LesniakM/sbr/hardware/sbr-pcb/pinout.png

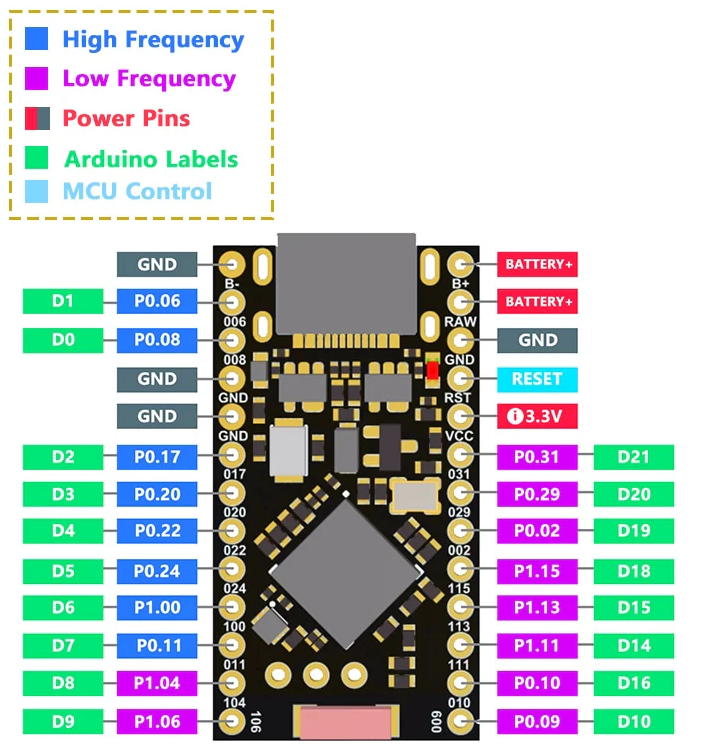
hardware/sbr-pcb/pinout.png
