LesniakM/sbr/hardware/sbr-pcb/sbr-pcb.kicad_pcb

## KiCad design hardware/sbr-pcb/sbr-pcb.kicad_pcb (2025-09-09)

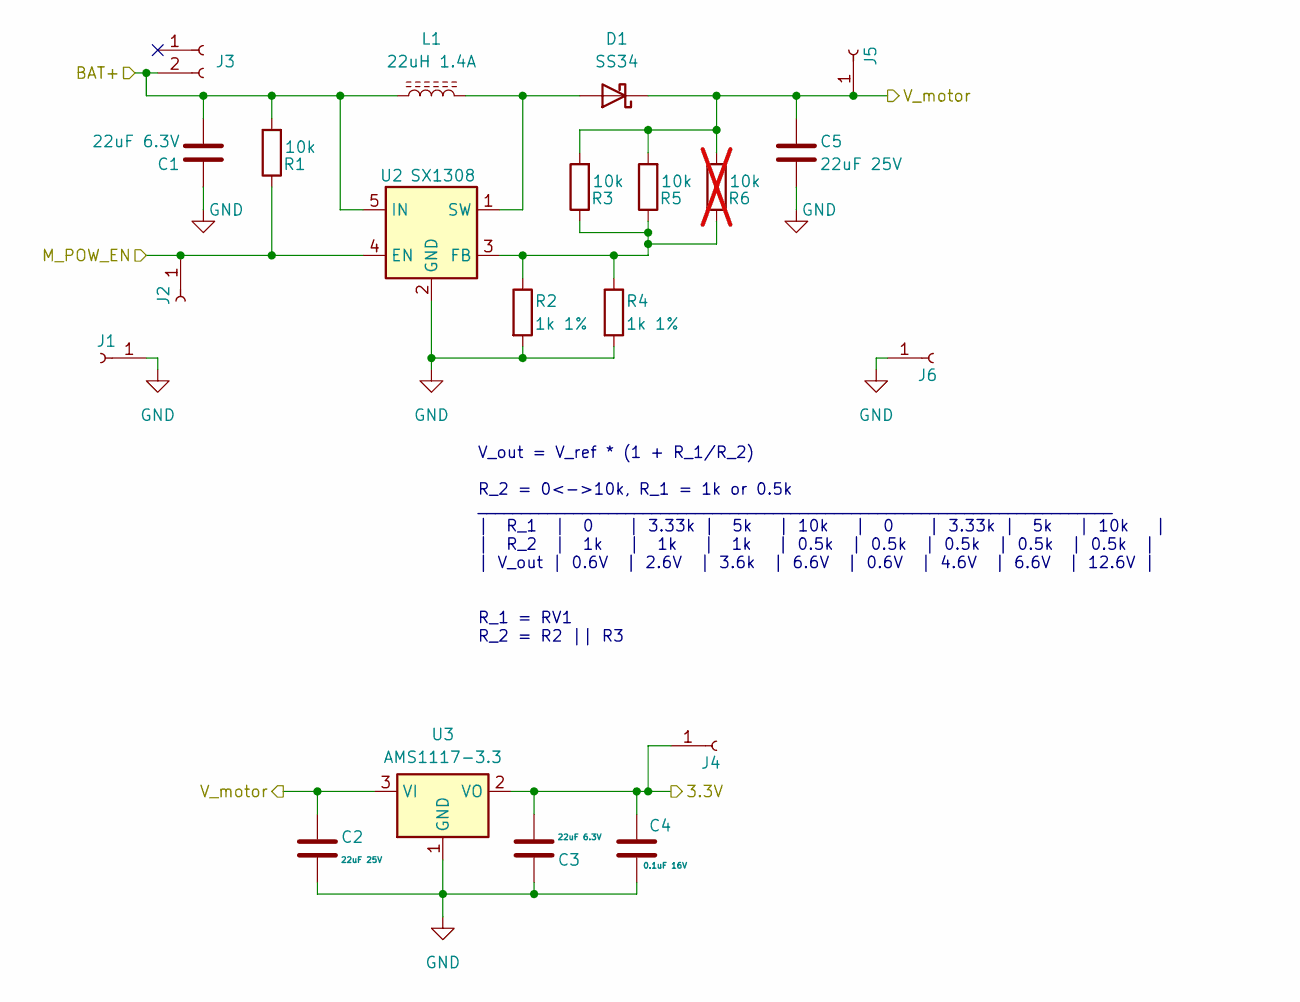
[picture p2: schematic power_managment.kicad_sch]

Parts:
C1, C3: 22uF 6.3V; C_0603_1608Metric; JLCPCB# C59461
C2, C5: 22uF 25V; C_0805_2012Metric; JLCPCB# C45783
C4: 0.1uF 16V; C_0402_1005Metric; JLCPCB# C1525
D1: SS34; D_SMA; JLCPCB# C8678
J1, J2, J4, J5, J6: Conn_hole; PinHeader_1x01_P2.54mm_Vertical
J3: Conn_01x02_Socket; PinHeader_1x02_P2.54mm_Vertical
L1: 22uH 1.4A; L_TDK_VLS6045EX_VLS6045AF; JLCPCB# C241601
R1, R3, R5: 10k; R_0603_1608Metric; JLCPCB# C25804
R2, R4: 1k 1%; R_0603_1608Metric; JLCPCB# C21190
R6: 10k; R_0603_1608Metric; JLCPCB# C25804; not fitted
U2: SX1308; SOT-23-6; LCSC Part # C78162
U3: AMS1117-3.3; SOT-223-3_TabPin2; JLCPCB# C6186

Connections:
/IMU/3.3V: C3.2, C4.1, J4.1, U3.2 (VO); also elsewhere on the board
/MCU/BAT+: C1.2, J3.2, L1.1, R1.2, U2.5 (IN); also elsewhere on the board
/MCU/M_POW_EN: J2.1, R1.1, U2.4 (EN); also elsewhere on the board
/motor_control/V_motor: C2.1, C5.1, D1.1 (K), J5.1, R3.2, R5.2, R6.2, U3.3 (VI); also elsewhere on the board
GND: C1.1, C2.2, C3.1, C4.2, C5.2, J1.1, J6.1, R2.2, R4.2, U2.2 (GND), U3.1 (GND); also elsewhere on the board
unnamed: D1.2 (A), L1.2, U2.1 (SW)
unnamed: R2.1, R3.1, R4.1, R5.1, R6.1, U2.3 (FB)

Notes on the sheet:
V_out = V_ref * (1 + R_1/R_2) R_2 = 0<->10k, R_1 = 1k or 0.5k _________________________________________________________________________ | R_1 | 0 | 3.33k | 5k | 10k | 0 | 3.33k | 5k | 10k | | R_2 | 1k | 1k | 1k | 0.5k | 0.5k | 0.5k | 0.5k | 0.5k | | V_out | 0.6V | 2.6V | 3.6k | 6.6V | 0.6V | 4.6V |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

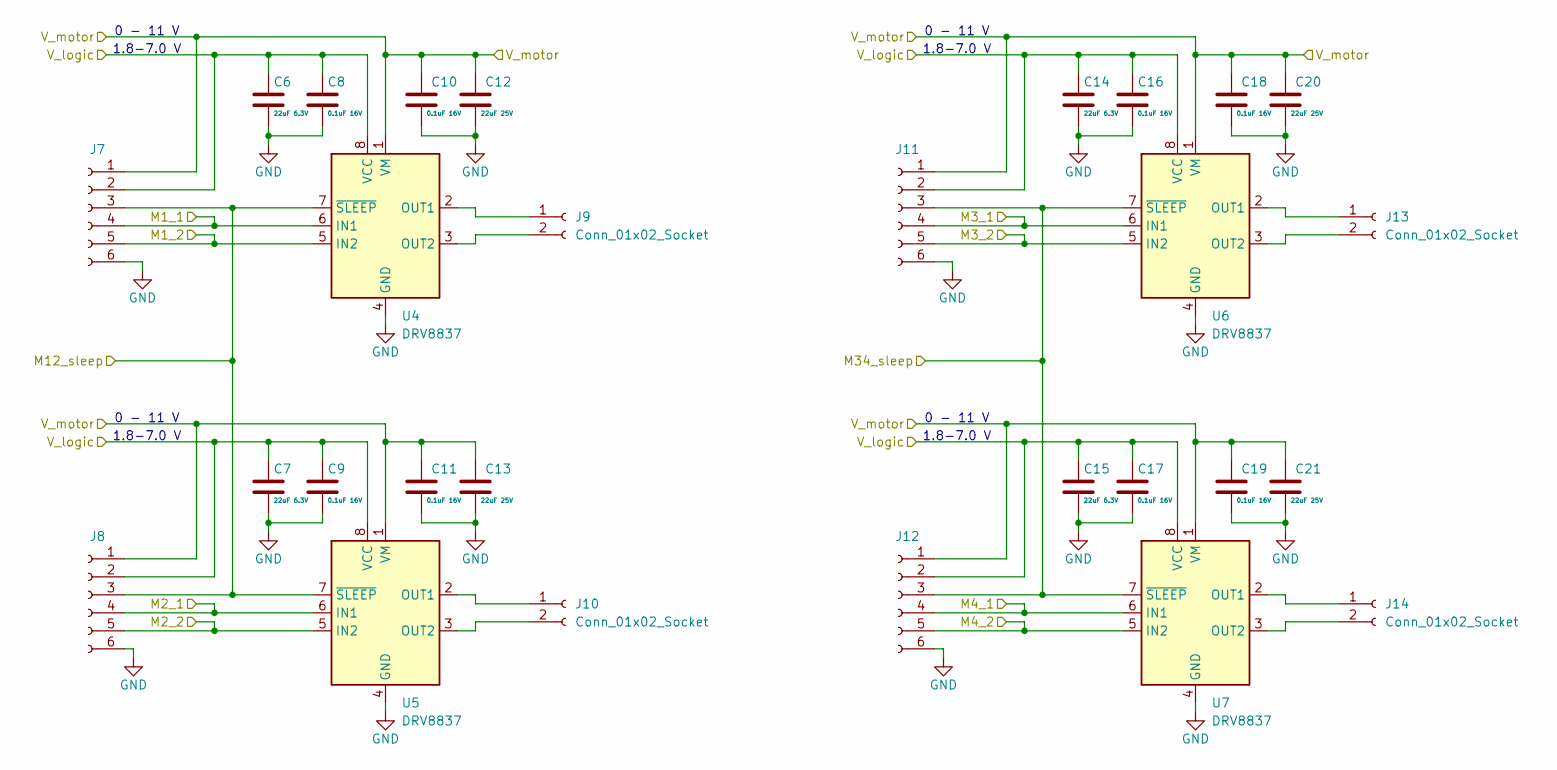
[picture p3: schematic motor_control.kicad_sch]

Parts:
C6, C7, C14, C15: 22uF 6.3V; C_0603_1608Metric; JLCPCB# C59461
C8, C9, C10, C11, C16, C17, C18, C19: 0.1uF 16V; C_0402_1005Metric; JLCPCB# C1525
C12, C13, C20, C21: 22uF 25V; C_0805_2012Metric; JLCPCB# C45783
J7, J8, J11, J12: Conn_01x06_Socket; PinHeader_1x06_P1.27mm_Vertical
J9, J10, J13, J14: Conn_01x02_Socket; PinSocket_1x02_P2.54mm_Vertical
U4, U5, U6, U7: DRV8837; WSON-8-1EP_2x2mm_P0.5mm_EP0.9x1.6mm; JLCPCB# C39159

Connections:
/IMU/3.3V: C6.1, C7.1, C8.1, C9.1, C14.1, C15.1, C16.1, C17.1, J7.2, J8.2, J11.2, J12.2, U4.8 (VCC), U5.8 (VCC), U6.8 (VCC), U7.8 (VCC); also elsewhere on the board
/MCU/M1_1: J7.4, U4.6 (IN1); also elsewhere on the board
/MCU/M1_2: J7.5, U4.5 (IN2); also elsewhere on the board
/MCU/M2_1: J8.4, U5.6 (IN1); also elsewhere on the board
/MCU/M2_2: J8.5, U5.5 (IN2); also elsewhere on the board
/MCU/M3_1: J11.4, U6.6 (IN1); also elsewhere on the board
/MCU/M3_2: J11.5, U6.5 (IN2); also elsewhere on the board
/MCU/M4_1: J12.4, U7.6 (IN1); also elsewhere on the board
/MCU/M4_2: J12.5, U7.5 (IN2); also elsewhere on the board
/MCU/M12_sleep: J7.3, J8.3, U4.7 (~SLEEP), U5.7 (~SLEEP); also elsewhere on the board
/MCU/M34_sleep: J11.3, J12.3, U6.7 (~SLEEP), U7.7 (~SLEEP); also elsewhere on the board
/motor_control/V_motor: C10.1, C11.1, C12.1, C13.1, C18.1, C19.1, C20.1, C21.1, J7.1, J8.1, J11.1, J12.1, U4.1 (VM), U5.1 (VM), U6.1 (VM), U7.1 (VM); also elsewhere on the board
GND: C6.2, C7.2, C8.2, C9.2, C10.2, C11.2, C12.2, C13.2, C14.2, C15.2, C16.2, C17.2, C18.2, C19.2, C20.2, C21.2, J7.6, J8.6, J11.6, J12.6, U4.4 (GND), U4.9 (GND), U5.4 (GND), U5.9 (GND), U6.4 (GND), U6.9 (GND), U7.4 (GND), U7.9 (GND); also elsewhere on the board
unnamed: J9.1, U4.2 (OUT1)
unnamed: J9.2, U4.3 (OUT2)
unnamed: J10.1, U5.2 (OUT1)
unnamed: J10.2, U5.3 (OUT2)
unnamed: J13.1, U6.2 (OUT1)
unnamed: J13.2, U6.3 (OUT2)
unnamed: J14.1, U7.2 (OUT1)
unnamed: J14.2, U7.3 (OUT2)

Notes on the sheet:
1.8-7.0 V
0 - 11 V

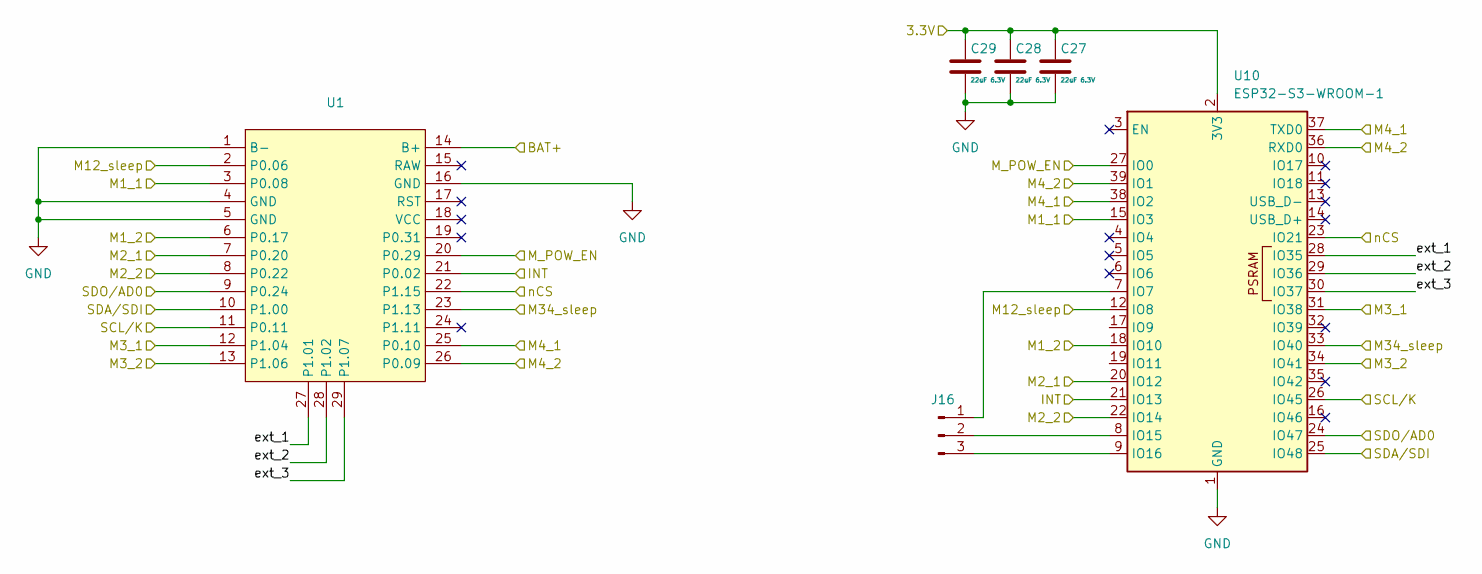
[picture p4: schematic mcu.kicad_sch]

Parts:
C27, C28, C29: 22uF 6.3V; C_0603_1608Metric; JLCPCB# C59461
J16: Conn_01x03_Pin; PinHeader_1x03_P2.54mm_Vertical
U1: ProMicro_nRF52840
U10: ESP32-S3-WROOM-1

Connections:
/IMU/3.3V: C27.1, C28.1, C29.1, U10.2 (3V3); also elsewhere on the board
/IMU/INT: U1.21 (P0.02), U10.21 (IO13); also elsewhere on the board
/IMU/SCL/K: U1.11 (P0.11), U10.26 (IO45); also elsewhere on the board
/IMU/SDA/SDI: U1.10 (P1.00), U10.25 (IO48); also elsewhere on the board
/IMU/SDO/AD0: U1.9 (P0.24), U10.24 (IO47); also elsewhere on the board
/IMU/nCS: U1.22 (P1.15), U10.23 (IO21); also elsewhere on the board
/MCU/BAT+: U1.14 (B+); also elsewhere on the board
/MCU/M1_1: U1.3 (P0.08), U10.15 (IO3); also elsewhere on the board
/MCU/M1_2: U1.6 (P0.17), U10.18 (IO10); also elsewhere on the board
/MCU/M2_1: U1.7 (P0.20), U10.20 (IO12); also elsewhere on the board
/MCU/M2_2: U1.8 (P0.22), U10.22 (IO14); also elsewhere on the board
/MCU/M3_1: U1.12 (P1.04), U10.31 (IO38); also elsewhere on the board
/MCU/M3_2: U1.13 (P1.06), U10.34 (IO41); also elsewhere on the board
/MCU/M4_1: U1.25 (P0.10), U10.37 (TXD0), U10.38 (IO2); also elsewhere on the board
/MCU/M4_2: U1.26 (P0.09), U10.36 (RXD0), U10.39 (IO1); also elsewhere on the board
/MCU/M12_sleep: U1.2 (P0.06), U10.12 (IO8); also elsewhere on the board
/MCU/M34_sleep: U1.23 (P1.13), U10.33 (IO40); also elsewhere on the board
/MCU/M_POW_EN: U1.20 (P0.29), U10.27 (IO0); also elsewhere on the board
/MCU/ext_1: U1.27 (P1.01), U10.28 (IO35)
/MCU/ext_2: U1.28 (P1.02), U10.29 (IO36)
/MCU/ext_3: U1.29 (P1.07), U10.30 (IO37)
GND: C27.2, C28.2, C29.2, U1.1 (B-), U1.4 (GND), U1.5 (GND), U1.16 (GND), U10.1 (GND), U10.40 (GND), U10.41 (GND); also elsewhere on the board
unnamed: J16.1, U10.7 (IO7)
unnamed: J16.2, U10.8 (IO15)
unnamed: J16.3, U10.9 (IO16)

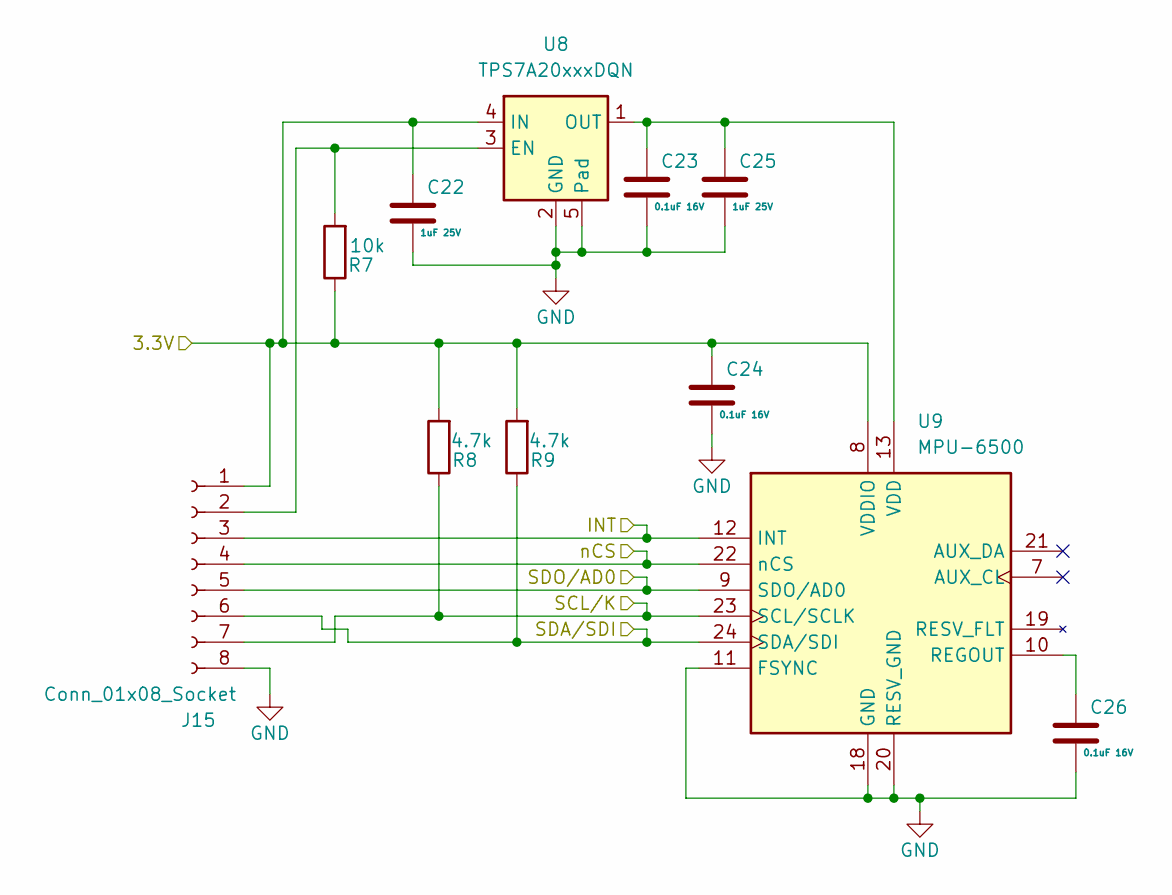
[picture p5: schematic imu.kicad_sch]

Parts:
C22, C25: 1uF 25V; C_0402_1005Metric; JLCPCB# C52923
C23, C24, C26: 0.1uF 16V; C_0402_1005Metric; JLCPCB# C1525
J15: Conn_01x08_Socket; PinSocket_1x08_P2.54mm_Vertical
R7: 10k; R_0603_1608Metric; JLCPCB# C25804
R8, R9: 4.7k; R_0603_1608Metric; JLCPCB# C23162
U8: TPS7A20xxxDQN; Texas_X2SON-4_1x1mm_P0.65mm; JLCPCB# C2878130
U9: MPU-6500; InvenSense_QFN-24_3x3mm_P0.4mm; JLCPCB# C50278

Connections:
/IMU/3.3V: C22.1, C24.1, J15.1, R7.1, R8.2, R9.2, U8.4 (IN), U9.8 (VDDIO); also elsewhere on the board
/IMU/INT: J15.3, U9.12 (INT); also elsewhere on the board
/IMU/SCL/K: J15.7, R8.1, U9.23 (SCL/SCLK); also elsewhere on the board
/IMU/SDA/SDI: J15.6, R9.1, U9.24 (SDA/SDI); also elsewhere on the board
/IMU/SDO/AD0: J15.5, U9.9 (SDO/AD0); also elsewhere on the board
/IMU/nCS: J15.4, U9.22 (nCS); also elsewhere on the board
GND: C22.2, C23.2, C24.2, C25.2, C26.2, J15.8, U8.2 (GND), U8.5 (Pad), U9.11 (FSYNC), U9.18 (GND), U9.20 (RESV_GND); also elsewhere on the board
unnamed: J15.2, R7.2, U8.3 (EN)
unnamed: C26.1, U9.10 (REGOUT)

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
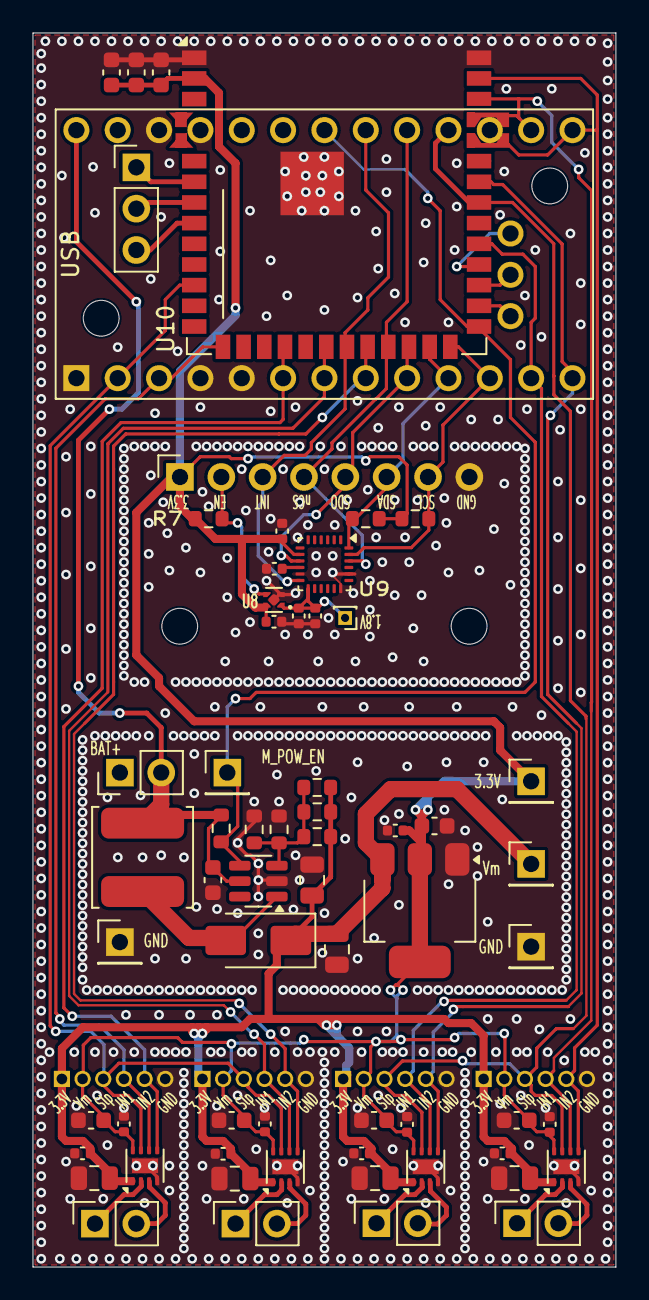
[picture p6: board sbr-pcb.kicad_pcb from above]

Board: 2 copper layers, 35.8 x 75.8 mm, 66 parts (0 on the bottom side), 39 nets.
