LesniakM/sbr/firmware/src/ble_comm.c

#include "ble_comm.h"

LOG_MODULE_REGISTER(SBR_BLE, LOG_LEVEL_DBG);

static struct sbr_callback sbr_cb;

static bool button_state;

BT_GATT_SERVICE_DEFINE(
    sbr_service, BT_GATT_PRIMARY_SERVICE(BT_UUID_SBR_SERVICE),

    BT_GATT_CHARACTERISTIC(BT_UUID_SBR_ACCEL, BT_GATT_CHRC_READ,
                           BT_GATT_PERM_READ, read_accel, NULL, &button_state),

    BT_GATT_CHARACTERISTIC(BT_UUID_SBR_GYRO, BT_GATT_CHRC_READ,
                           BT_GATT_PERM_READ, read_gyro, NULL, &button_state),

    BT_GATT_CHARACTERISTIC(BT_UUID_SBR_CONTROL, BT_GATT_CHRC_WRITE,
                           BT_GATT_PERM_WRITE, NULL, update_control, NULL));

const struct bt_le_adv_param *adv_param =
    BT_LE_ADV_PARAM((BT_LE_ADV_OPT_CONN |
                     BT_LE_ADV_OPT_USE_IDENTITY), /* Connectable advertising and
                                                     use identity address */
                    800, /* Min Advertising Interval 500ms (800*0.625ms) */
                    801, /* Max Advertising Interval 500.625ms (801*0.625ms) */
                    NULL); /* Set to NULL for undirected advertising */

const struct bt_data ad[] = {
    BT_DATA_BYTES(BT_DATA_FLAGS, (BT_LE_AD_GENERAL | BT_LE_AD_NO_BREDR)),
    BT_DATA(BT_DATA_NAME_COMPLETE, DEVICE_NAME, DEVICE_NAME_LEN),
};

const struct bt_data sd[] = {
    BT_DATA_BYTES(BT_DATA_UUID128_ALL, BT_UUID_SBR_SERVICE_VAL),
};

ssize_t read_accel(struct bt_conn *conn, const struct bt_gatt_attr *attr,
                   void *buf, uint16_t len, uint16_t offset) {
  // get a pointer to button_state which is passed in the
  // BT_GATT_CHARACTERISTIC() and stored in attr->user_data
  const char *value = attr->user_data;

  // LOG_DBG("Attribute read, handle: %u, conn: %p", attr->handle, (void
  // *)conn);

  if (sbr_cb.button_cb) {
    // Call the application callback function to update the get the current
    // value of the button
    button_state = sbr_cb.button_cb();
    return bt_gatt_attr_read(conn, attr, buf, len, offset, value,
                             sizeof(*value));
  }

  return 0;
}

ssize_t read_gyro(struct bt_conn *conn, const struct bt_gatt_attr *attr,
                  void *buf, uint16_t len, uint16_t offset) {
  // get a pointer to button_state which is passed in the
  // BT_GATT_CHARACTERISTIC() and stored in attr->user_data
  const char *value = attr->user_data;

  // LOG_DBG("Attribute read, handle: %u, conn: %p", attr->handle, (void
  // *)conn);

  if (sbr_cb.button_cb) {
    // Call the application callback function to update the get the current
    // value of the button
    button_state = sbr_cb.button_cb();
    return bt_gatt_attr_read(conn, attr, buf, len, offset, value,
                             sizeof(*value));
  }

  return 0;
}

ssize_t update_control(struct bt_conn *conn, const struct bt_gatt_attr *attr,
                       const void *buf, uint16_t len, uint16_t offset,
                       uint8_t flags) {
  // LOG_DBG("Attribute write, handle: %u, conn: %p", attr->handle, (void
  // *)conn);

  if (len != 1U) {
    // LOG_DBG("Write led: Incorrect data length");
    return BT_GATT_ERR(BT_ATT_ERR_INVALID_ATTRIBUTE_LEN);
  }

  if (offset != 0) {
    // LOG_DBG("Write led: Incorrect data offset");
    return BT_GATT_ERR(BT_ATT_ERR_INVALID_OFFSET);
  }

  if (sbr_cb.led_cb) {
    // Read the received value
    uint8_t val = *((uint8_t *)buf);

    if (val == 0x00 || val == 0x01) {
      // Call the application callback function to update the LED state
      sbr_cb.led_cb(val ? true : false);
    } else {
      // LOG_DBG("Write led: Incorrect value");
      return BT_GATT_ERR(BT_ATT_ERR_VALUE_NOT_ALLOWED);
    }
  }

  return len;
}

int ble_init(struct sbr_callback *callbacks) {
  if (callbacks) {
    sbr_cb.led_cb = callbacks->led_cb;
    sbr_cb.button_cb = callbacks->button_cb;
  }

  return 0;
}

void on_connected(struct bt_conn *conn, uint8_t err) {
  if (err) {
    LOG_ERR("Connection failed (err %u)", err);
    return;
  }

  LOG_INF("Connected\n");
}

void on_le_param_updated(struct bt_conn *conn, uint16_t interval,
                         uint16_t latency, uint16_t timeout) {
  double connection_interval = interval * 1.25; // in ms
  uint16_t supervision_timeout = timeout * 10;  // in ms
  LOG_INF("Connection parameters updated: interval %.2f ms, latency %d "
          "intervals, timeout %d ms",
          connection_interval, latency, supervision_timeout);
}

void on_disconnected(struct bt_conn *conn, uint8_t reason) {
  LOG_INF("Disconnected (reason %u)", reason);
}

struct bt_conn_cb connection_callbacks = {
    .connected = on_connected,
    .le_param_updated = on_le_param_updated,
    .disconnected = on_disconnected,
};

void sbr_contrl_cb(bool state) {
  // dk_set_led(USER_LED, led_state);
}

bool sbr_accel_cb(void) { return false; }

bool sbr_gyro_cb(void) { return true; }

struct sbr_callback sbr_callbacks = {
    .led_cb = sbr_contrl_cb,
    .button_cb = sbr_accel_cb,
};

int start_ble(void) {
  int err = 0;
  err = bt_enable(NULL);
  if (err) {
    LOG_ERR("Bluetooth init failed (err %d)", err);
    return err;
  }
  LOG_DBG("Bluetooth initialized.");

  err = bt_conn_cb_register(&connection_callbacks);
  if (err) {
    LOG_ERR("Failed to register connection callbacks (err %d)", err);
    return err;
  }
  LOG_DBG("cb registered.");

  err = ble_init(&sbr_callbacks);
  if (err) {
    LOG_ERR("Failed to init LBS (err:%d)", err);
    return err;
  }
  LOG_DBG("ble_init ok.");

  err = bt_le_adv_start(adv_param, ad, ARRAY_SIZE(ad), sd, ARRAY_SIZE(sd));
  if (err) {
    LOG_ERR("Advertising failed to start (err %d)", err);
    return err;
  }
  return 0;
}
