LesniakM/sbr/firmware/src/periphals.c

#include "periphals.h"

#define LED0_NODE DT_ALIAS(led0) // LED0_NODE = led0 defined in the .dts file
#define MPU6500_ADDRESS_NODE DT_ALIAS(mpu6500_address)
#define I2C0_MPU_NODE DT_NODELABEL(mpu6500)
const struct gpio_dt_spec led = GPIO_DT_SPEC_GET(LED0_NODE, gpios);
const struct gpio_dt_spec mpu6500_address_pin = GPIO_DT_SPEC_GET(MPU6500_ADDRESS_NODE, gpios); 
const struct i2c_dt_spec dev_i2c = I2C_DT_SPEC_GET(I2C0_MPU_NODE);

LOG_MODULE_REGISTER(SBR_periphals, LOG_LEVEL_DBG);

int configure_gpios() {
  int ret;

  ret = gpio_pin_configure_dt(&led, GPIO_OUTPUT_ACTIVE);
  if (ret != 0) {
    LOG_ERR("Error %d: failed to configure LED pin %d\n", ret, led.pin);
    return ret;
  }

  // ret = gpio_pin_configure_dt(&mpu6500_address_pin, GPIO_OUTPUT_INACTIVE);
  /*if (ret != 0) {
      LOG_ERR("Error %d: failed to configure mpu6500 address pin %d\n", ret,
  mpu6500_address_pin.pin); return ret;
  }*/
  // ret = gpio_pin_configure_dt(&m_driver_12_sleep, GPIO_OUTPUT_ACTIVE);
  /*if (ret != 0) {
      LOG_ERR("Error %d: failed to configure m_driver_12_sleep pin %d\n", ret,
  m_driver_12_sleep.pin); return ret;
  }*/
  LOG_DBG("GPIO configured.");
  return 0;
}

#define SW1_NODE DT_ALIAS(bt1)
static const struct gpio_dt_spec button1 = GPIO_DT_SPEC_GET(SW1_NODE, gpios);
// #define SW1_NODE DT_ALIAS(bt2)
// static const struct gpio_dt_spec button2 = GPIO_DT_SPEC_GET(SW1_NODE, gpios);

static struct gpio_callback button1_cb_data;
// static struct gpio_callback button2_cb_data;

void button1_cb(const struct device *dev, struct gpio_callback *cb,
                uint32_t pins) {
  if (gpio_pin_get_dt(&button1)) {
    button1_pressed();
  } else {
    button1_released();
  }
}

void button1_pressed() {
  printk("btn down cb\n");
  // drive = true;
}

void button1_released() {
  printk("btn up cb\n");
  // drive = true;
}

/*
void button2_pressed_cb(const struct device *dev, struct gpio_callback *cb,
uint32_t pins)
{
    gpio_pin_set_dt(&led, 0);
    drive = false;
}
*/

int config_buttons_callbacks() {
  int ret = 0;
  ret = gpio_pin_configure_dt(&button1, GPIO_INPUT);
  // gpio_pin_configure_dt(&button2, GPIO_INPUT);
  if (ret != 0) {
    LOG_ERR("Button GPIO config failed with error: %d", ret);
    return ret;
  }

  // Setup interrupts for pins:
  ret = gpio_pin_interrupt_configure_dt(&button1, GPIO_INT_EDGE_BOTH);
  // gpio_pin_interrupt_configure_dt(&button2, GPIO_INT_EDGE_TO_ACTIVE);
  if (ret != 0) {
    LOG_ERR("Button interrupt config failed with error: %d", ret);
    return ret;
  }

  // Initialize the static struct gpio_callback variable
  gpio_init_callback(&button1_cb_data, button1_cb, BIT(button1.pin));
  // gpio_init_callback(&button2_cb_data, button2_pressed_cb, BIT(button2.pin));

  // Add the callback function by calling gpio_add_callback()
  gpio_add_callback(button1.port, &button1_cb_data);
  // gpio_add_callback(button2.port, &button2_cb_data);
  k_msleep(10);

  LOG_DBG("Button callback registered.");
  return ret;
}
