LesniakM/sbr/(commit log)

2025-09-14 Formating and error handling
    [main.c, periphals.c, periphals.h]
2025-12-15 IMU read in separate thread
